JhoanLeon/output-controller/(list of files, drawings)

Other design files:
simulation/output_controller_simulation.pdsprj
