JhoanLeon/output-controller/hardware/output_controller_schematic.brd

## EAGLE design hardware/output_controller_schematic.brd (2022-08-25)

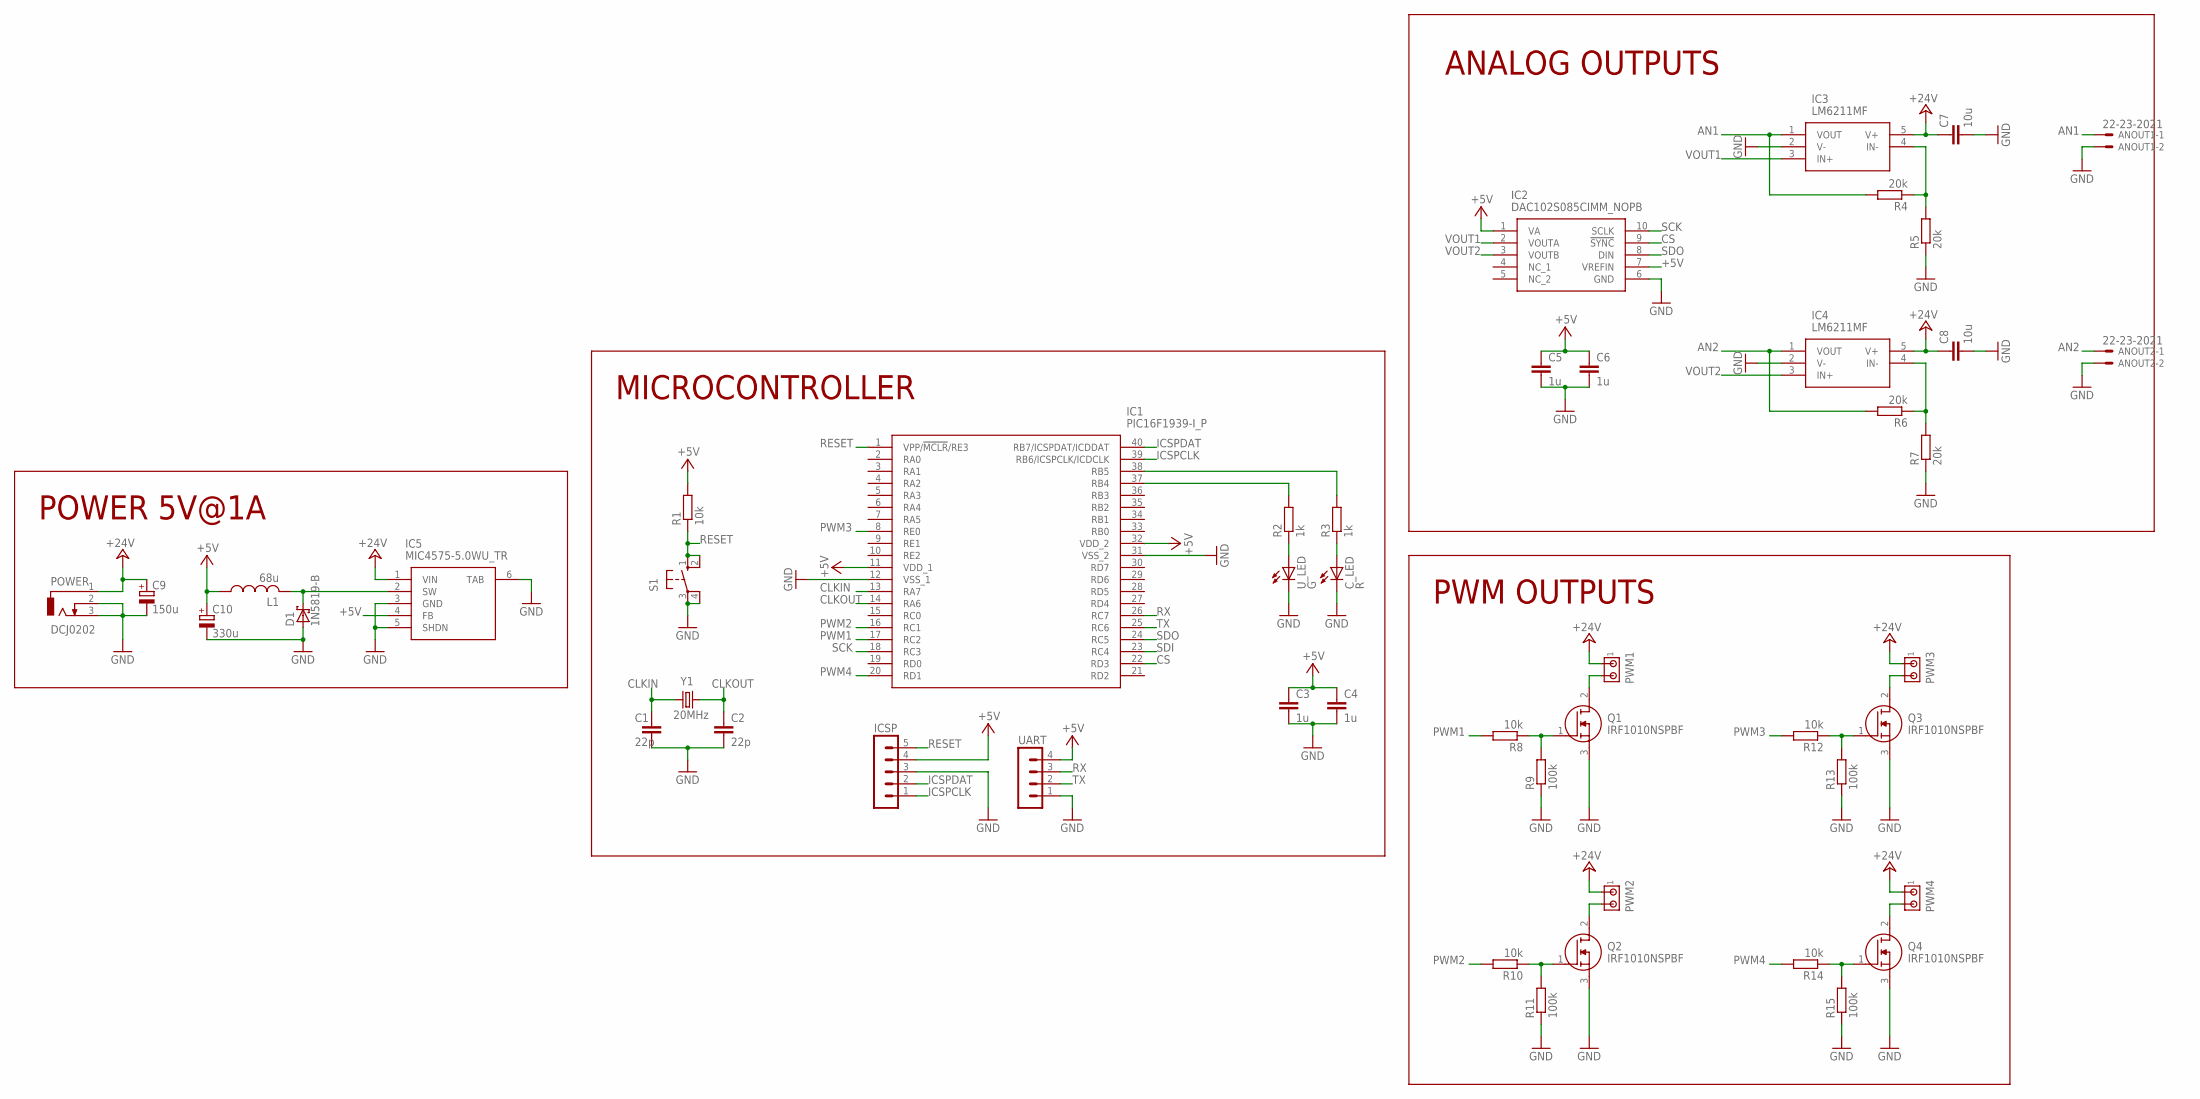
[picture p3: schematic output_controller_schematic.sch]

Parts:
ANOUT1, ANOUT2: 22-23-2021
C1, C2: 22p; C1206
C3, C4, C5, C6: 1u; C1206
C7, C8: 10u; C1206
C9: 150u; 175TMP-0810
C10: 330u; 175TMP-0810
C_LED: R; CHIPLED_1206
D1: 1N5819-B; DO41-7.6
IC1: PIC16F1939-I_P; DIP1543W58P254L5175H635Q40N
IC2: DAC102S085CIMM_NOPB; SOP50P490X110-10N
IC3, IC4: LM6211MF; SOT95P284X122-5N
IC5: MIC4575-5.0WU_TR; MIC2930112WU
ICSP: MA05-1
L1: 68u; L5650M
POWER: DCJ0202
PWM1, PWM2, PWM3, PWM4: MTA02-156; 1X2MTA
Q1, Q2, Q3, Q4: IRF1010NSPBF; IRF2804STRLPBF
R1, R8, R10, R12, R14: 10k; R1206
R2, R3: 1k; R1206
R4, R5, R6, R7: 20k; R1206
R9, R11, R13, R15: 100k; R1206
S1: 10-XX; B3F-10XX
UART: MA04-1
U_LED: G; CHIPLED_1206
Y1: 20MHz; HC49/S

Connections:
+5V: C3.1, C4.1, C5.1, C6.1, C10.+, IC1.11 (VDD_1), IC1.32 (VDD_2), IC2.1 (VA), IC2.7 (VREFIN), IC5.4 (FB), ICSP.4, L1.1, R1.2, UART.4
+24V: C7.1, C8.1, C9.+, IC3.5 (V+), IC4.5 (V+), IC5.1 (VIN), POWER.1, PWM1.1, PWM2.1, PWM3.1, PWM4.1
AN1: ANOUT1.1, IC3.1 (VOUT), R4.2
AN2: ANOUT2.1, IC4.1 (VOUT), R6.2
CLKIN: C1.1, IC1.13 (RA7), Y1.1
CLKOUT: C2.1, IC1.14 (RA6), Y1.2
CS: IC1.22 (RD3), IC2.9 (!SYNC)
GND: ANOUT1.2, ANOUT2.2, C1.2, C2.2, C3.2, C4.2, C5.2, C6.2, C7.2, C8.2, C9.-, C10.-, C_LED.C, D1.A, IC1.12 (VSS_1), IC1.31 (VSS_2), IC2.6 (GND), IC3.2 (V-), IC4.2 (V-), IC5.3 (GND), IC5.5 (SHDN), IC5.6 (TAB), ICSP.3, POWER.2, POWER.3, Q1.3 (S), Q2.3 (S), Q3.3 (S), Q4.3 (S), R5.1, R7.1, R9.1, R11.1, R13.1, R15.1, S1.3, S1.4 (P1), UART.1, U_LED.C
ICSPCLK: IC1.39 (RB6/ICSPCLK/ICDCLK), ICSP.1
ICSPDAT: IC1.40 (RB7/ICSPDAT/ICDDAT), ICSP.2
unnamed: IC3.4 (IN-), R4.1, R5.2
unnamed: IC4.4 (IN-), R6.1, R7.2
unnamed: IC1.38 (RB5), R3.2
unnamed: IC1.37 (RB4), R2.2
unnamed: R2.1, U_LED.A
unnamed: C_LED.A, R3.1
unnamed: Q1.1 (G), R8.1, R9.2
unnamed: PWM1.2, Q1.2 (D)
unnamed: Q2.1 (G), R10.1, R11.2
unnamed: PWM2.2, Q2.2 (D)
unnamed: Q3.1 (G), R12.1, R13.2
unnamed: PWM3.2, Q3.2 (D)
unnamed: Q4.1 (G), R14.1, R15.2
unnamed: PWM4.2, Q4.2 (D)
unnamed: D1.C, IC5.2 (SW), L1.2
PWM1: IC1.17 (RC2), R8.2
PWM2: IC1.16 (RC1), R10.2
PWM3: IC1.8 (RE0), R12.2
PWM4: IC1.20 (RD1), R14.2
RESET: IC1.1 (VPP/!MCLR!/RE3), ICSP.5, R1.1, S1.1 (S), S1.2 (S1)
RX: IC1.26 (RC7), UART.3
SCK: IC1.18 (RC3), IC2.10 (SCLK)
SDI: IC1.23 (RC4)
SDO: IC1.24 (RC5), IC2.8 (DIN)
TX: IC1.25 (RC6), UART.2
VOUT1: IC2.2 (VOUTA), IC3.3 (IN+)
VOUT2: IC2.3 (VOUTB), IC4.3 (IN+)

Notes on the sheet:
POWER 5V@1A
MICROCONTROLLER
ANALOG OUTPUTS
PWM OUTPUTS

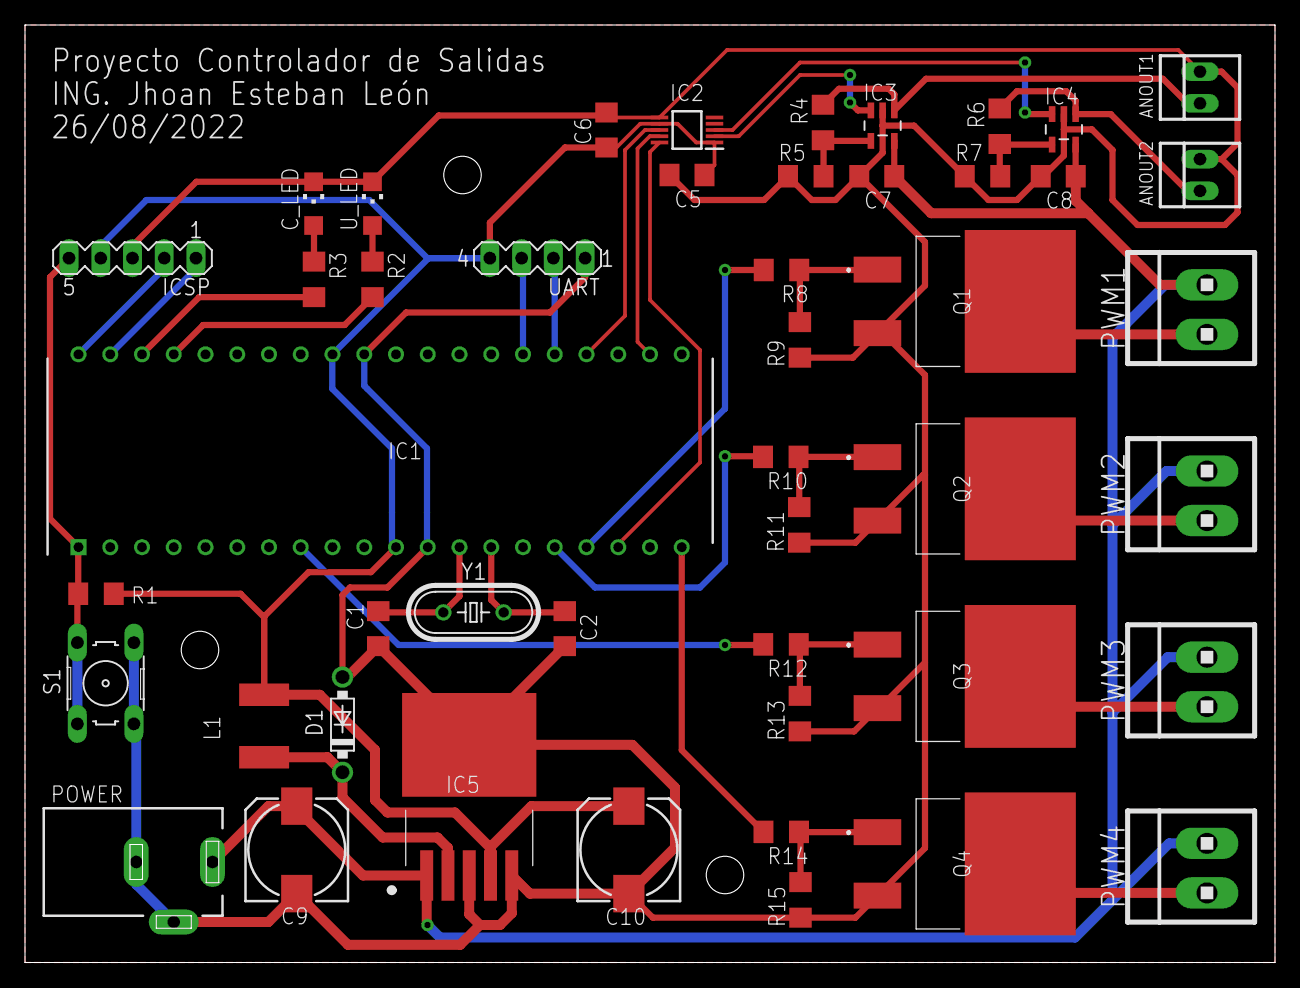
[picture p4: board output_controller_schematic.brd from above]

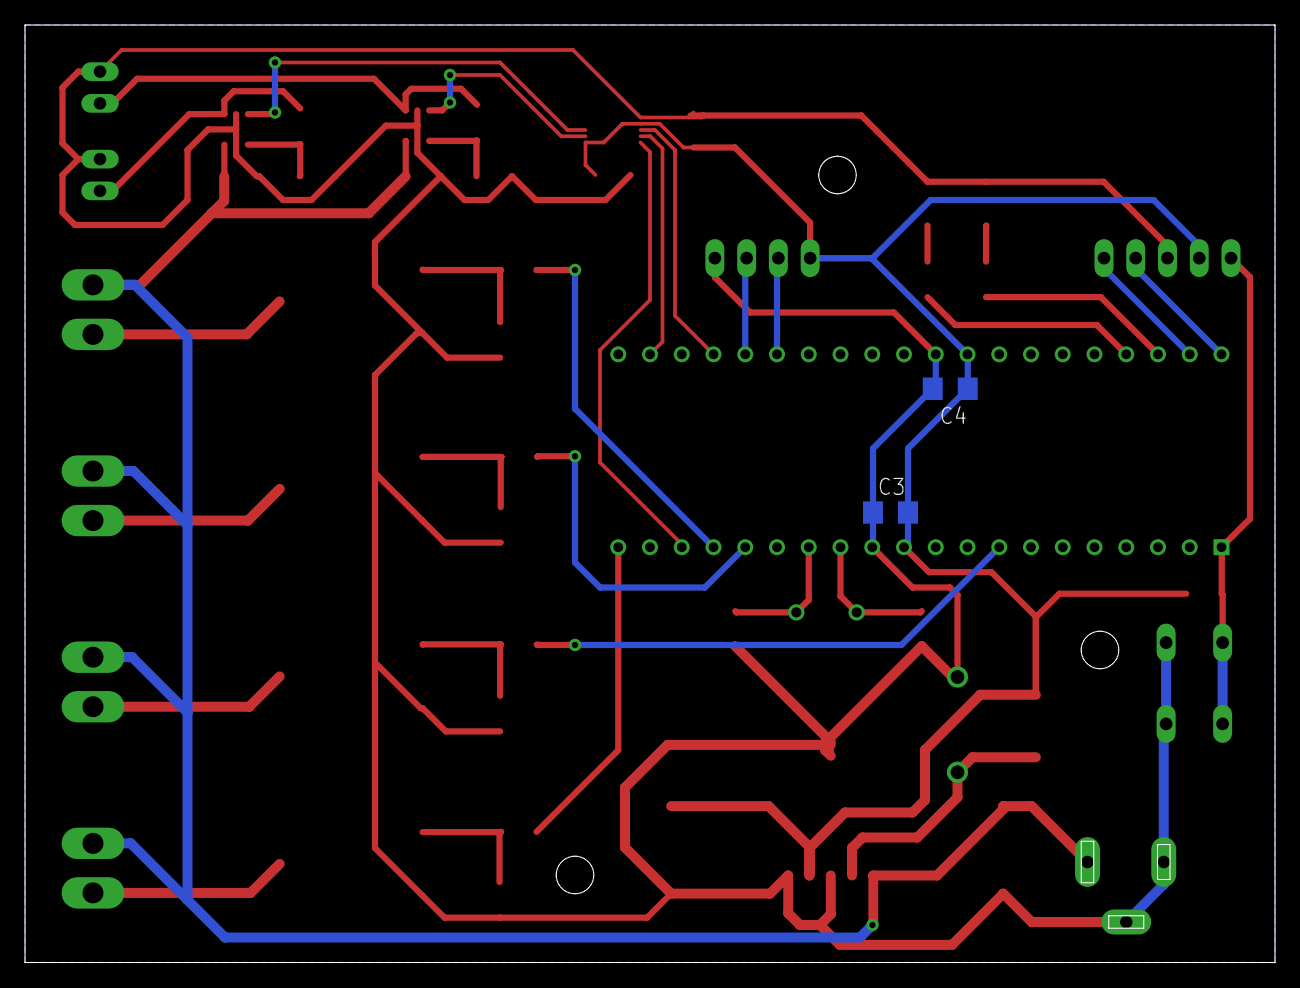
[picture p5: board output_controller_schematic.brd from below]

Board: 2 copper layers, 100.0 x 75.0 mm, 49 parts (2 on the bottom side), 36 nets.
