JhoanLeon/output-controller/(commit log)

2022-08-23 First steps in schematic design
    [output_controller_schematic.sch, output_controller_simulation.pdsprj]
2022-08-23 documentation and anouts added
    [output_controller_simulation.pdsprj]
2022-08-23 pwm outputs completed
    [output_controller_schematic.sch, output_controller_simulation.pdsprj]
2022-08-24 complete schematic design and PCB layout generated
    [output_controller_schematic.brd, output_controller_schematic.sch]
2022-08-24 first uncomplete organization of PCB layout
    [output_controller_schematic.sch]
2022-08-25 start code and simulation with blinking leds
    [output_controller_schematic.brd, output_controller_schematic.sch, output_controller_simulation.pdsprj]
2022-08-26 first code to PWM generation
    [output_controller_simulation.pdsprj]
2022-08-26 first implementation of UART communication
    [output_controller_simulation.pdsprj]
2022-08-27 stable working version of 90% uart protocol
2022-08-27 final commented version of code
    [output_controller_simulation.pdsprj]
2022-12-09 adding final files
    [output_controller_simulation.pdsprj]
